oowen98/Autonomous-RC-Car-Milestone-1/Photos/IMG-2980.JPG

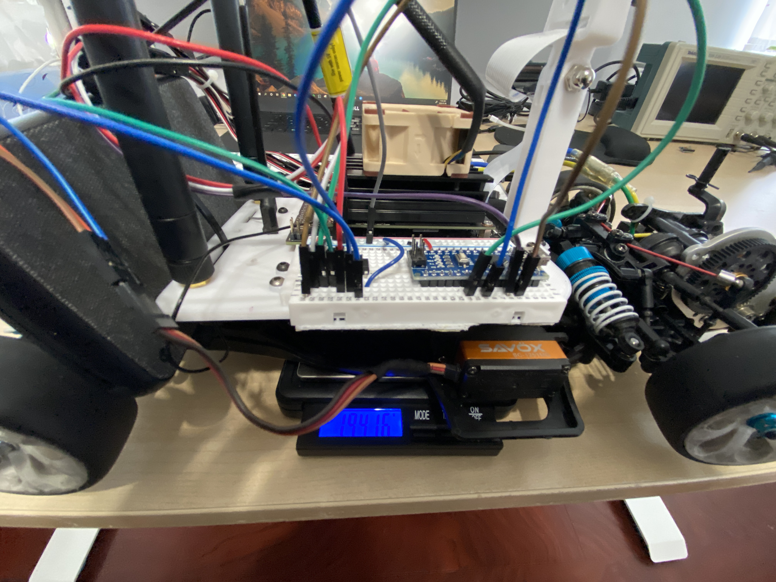
Photos/IMG-2980.JPG
