oowen98/Autonomous-RC-Car-Milestone-1/Photos/IMG-3213.jpg

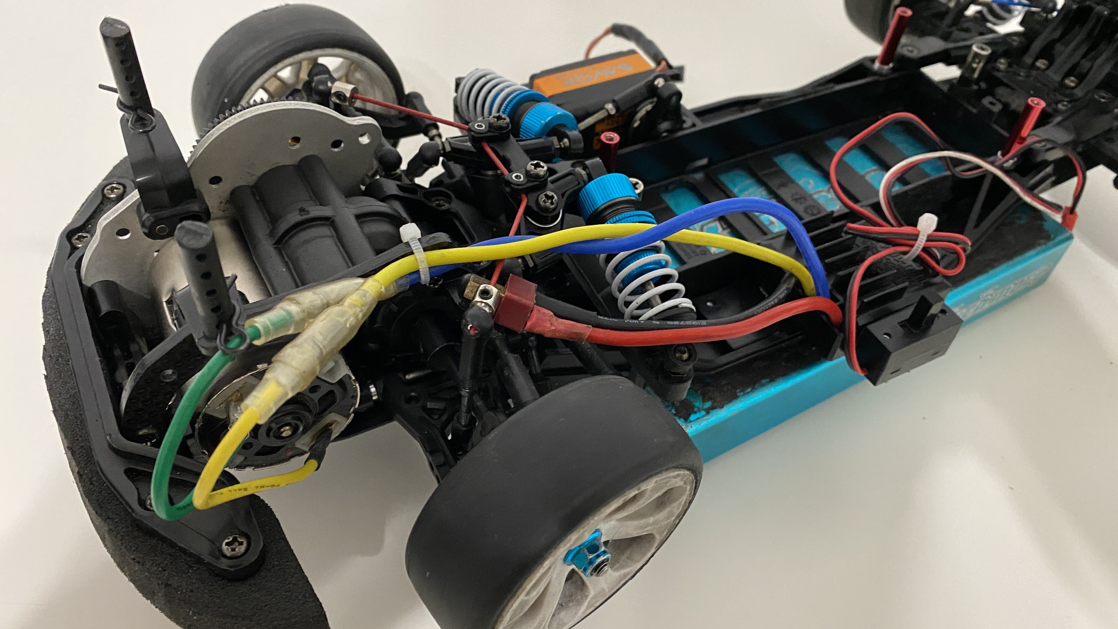
Photos/IMG-3213.jpg
